FrankTrover/2023-Diansai-H/report/ppt图片/图片说明.txt

第一版加法器：第一版MCP602，电源导致带宽不足，电容过大充放电影响，截止频率没有调好
第一版后级放大电路：TL072由于频率升高后电路中寄生电容和运放有限带宽的影响增强，使负反馈性能下降并产生相位滞后，从而导致输出波形失真。
第二版加法器：两路跟随输出经加法电阻汇合属于正常工作方式，输出出现尖峰及 0 V 平台主要是由于高频下后级反相求和电路在面包板上的长连线和寄生参数影响负反馈稳定性，使虚地点产生波动，运放进入瞬态非线性状态，从而造成波形畸变。
