FrankTrover/2023-Diansai-H/report/ppt图片/第一版加法器 (2).jpg

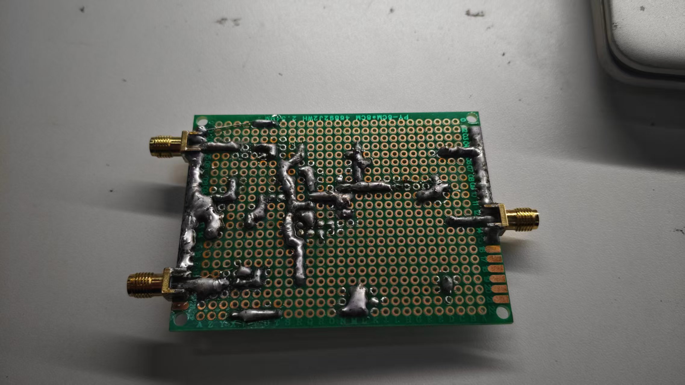
report/ppt图片/第一版加法器 (2).jpg
