FrankTrover/2023-Diansai-H/report/ppt图片/第一版放大器 (3).jpg

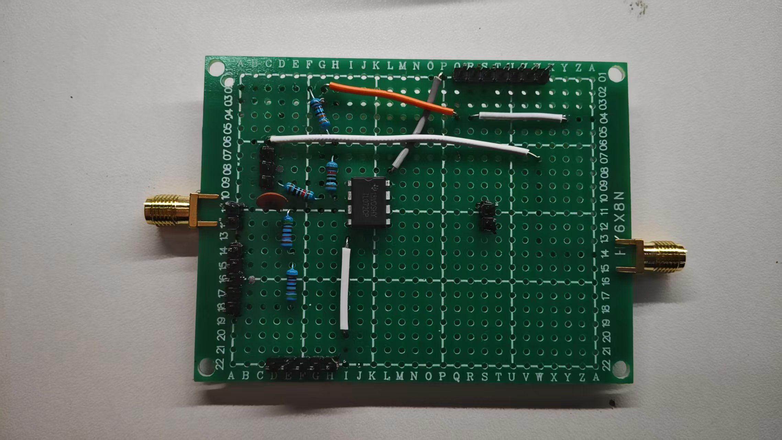
report/ppt图片/第一版放大器 (3).jpg
