FrankTrover/2023-Diansai-H/report/slide-01.jpg

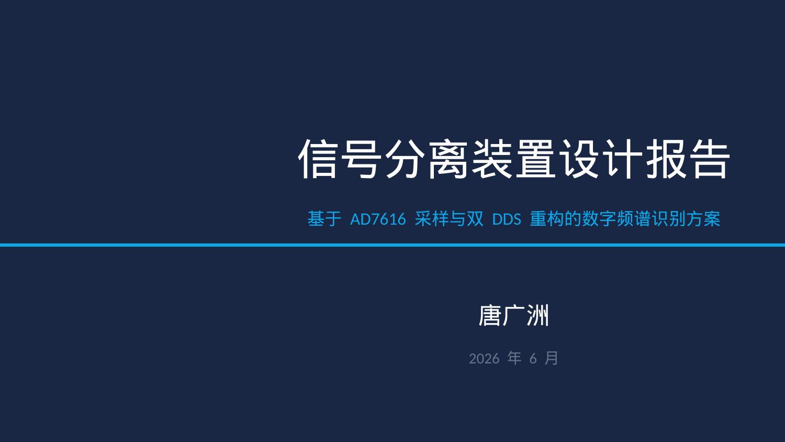
report/slide-01.jpg
