FrankTrover/2023-Diansai-H/report/slide-02.jpg

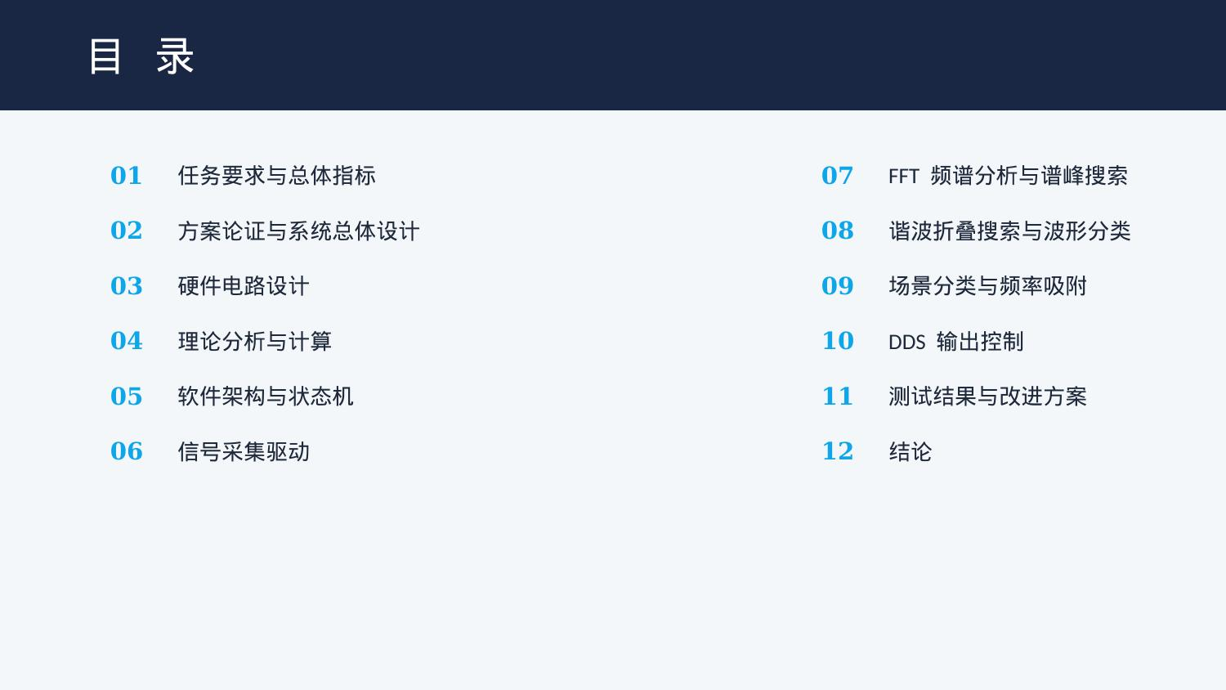
report/slide-02.jpg
