FrankTrover/2023-Diansai-H/report/slide-03.jpg

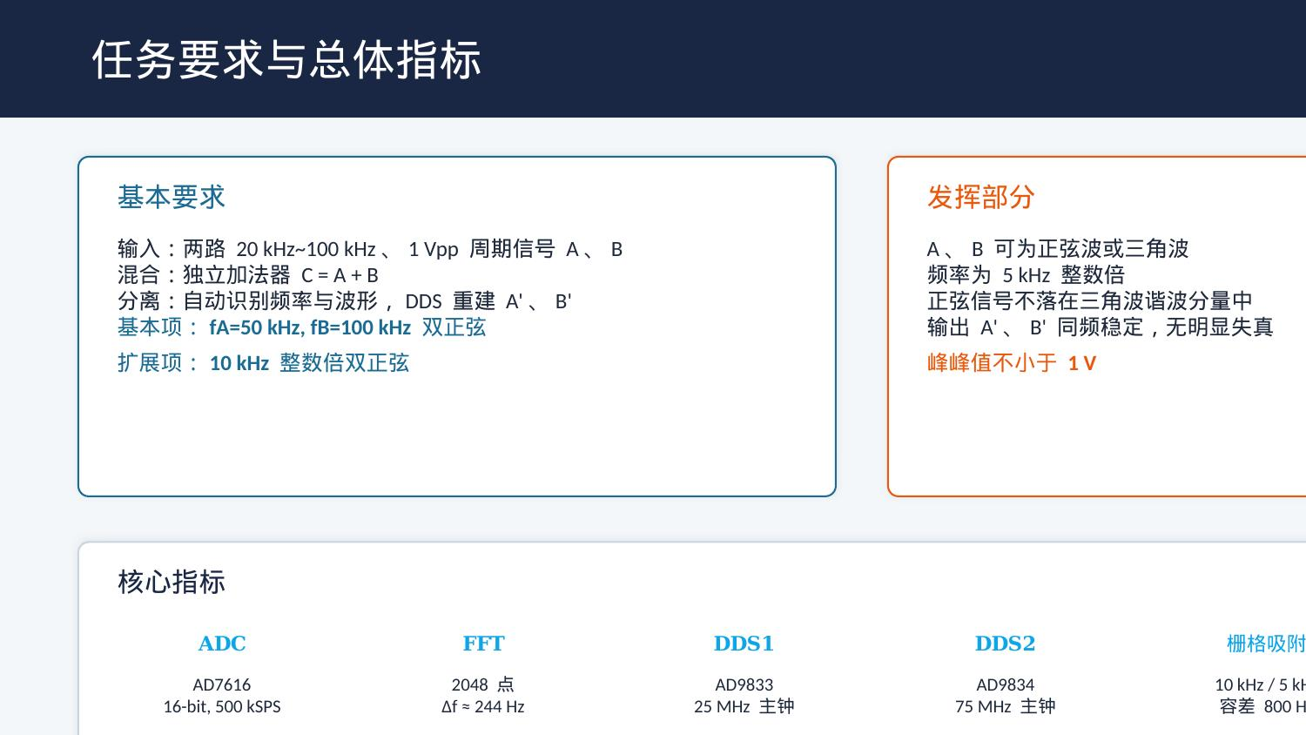
report/slide-03.jpg
