FrankTrover/2023-Diansai-H/report/slide-04.jpg

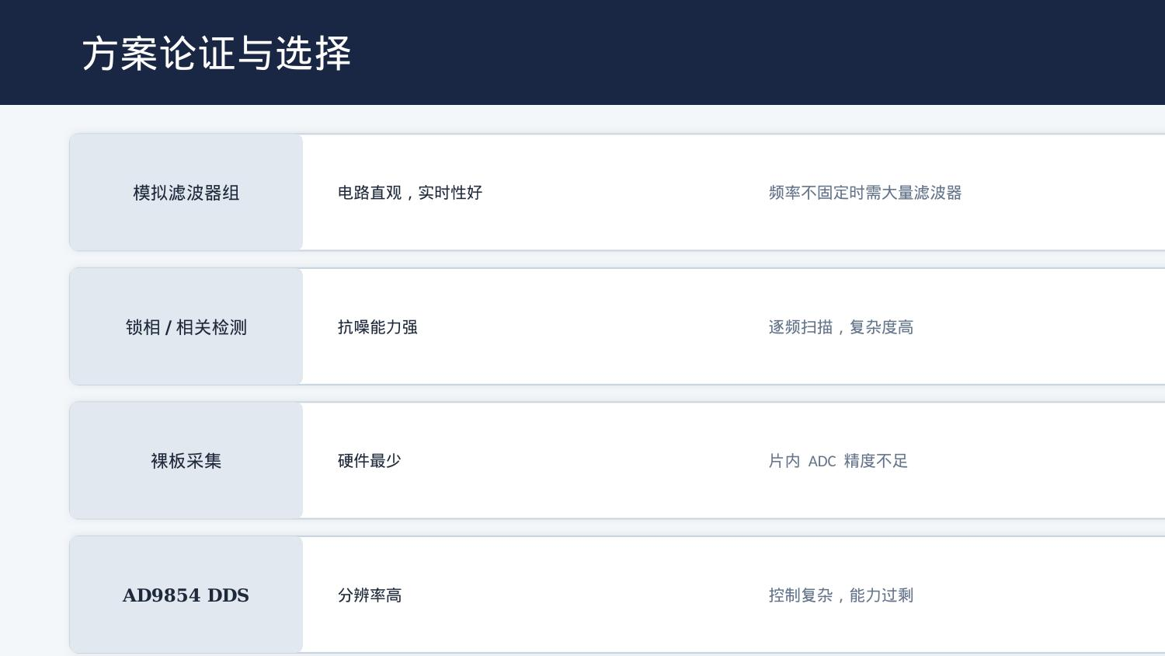
report/slide-04.jpg
