FrankTrover/2023-Diansai-H/report/slide-05.jpg

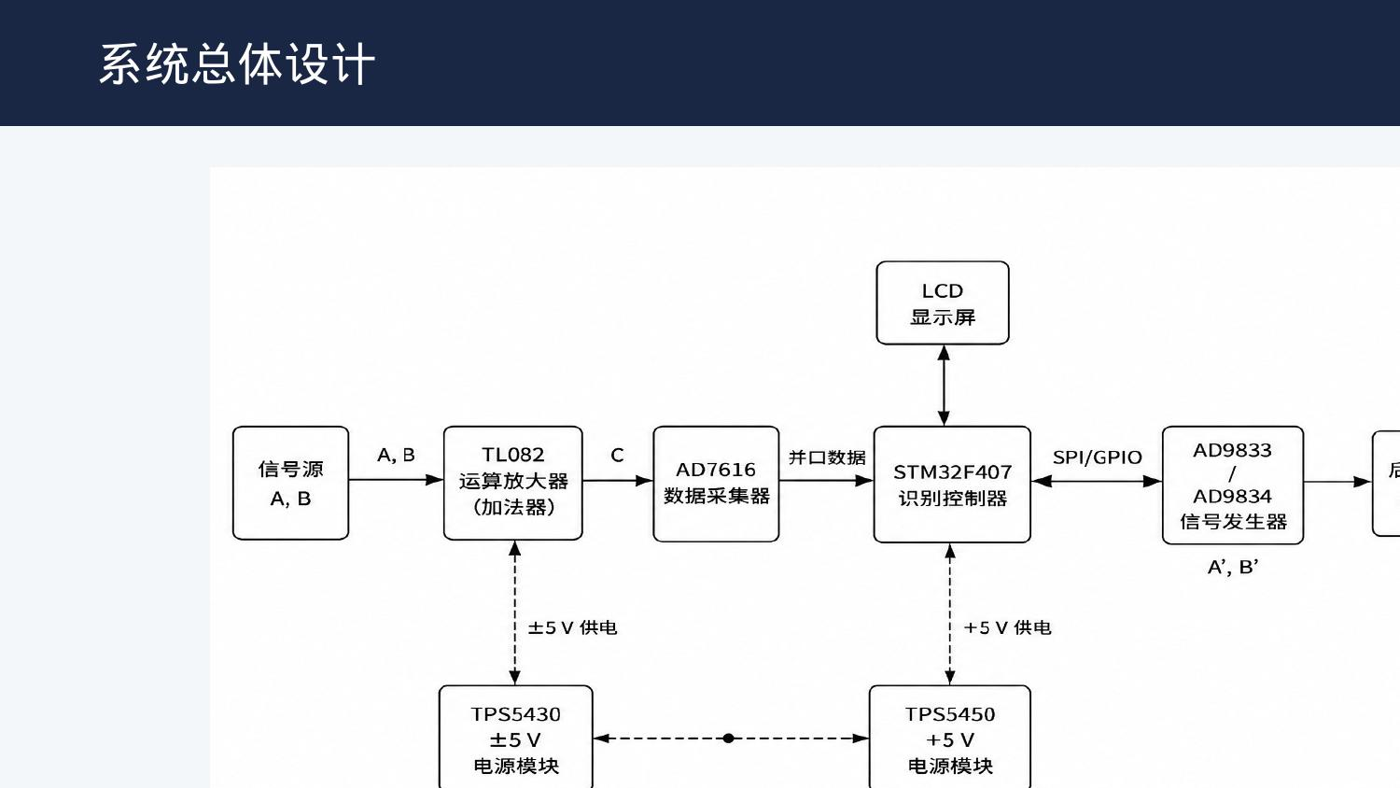
report/slide-05.jpg
