FrankTrover/2023-Diansai-H/report/slide-06.jpg

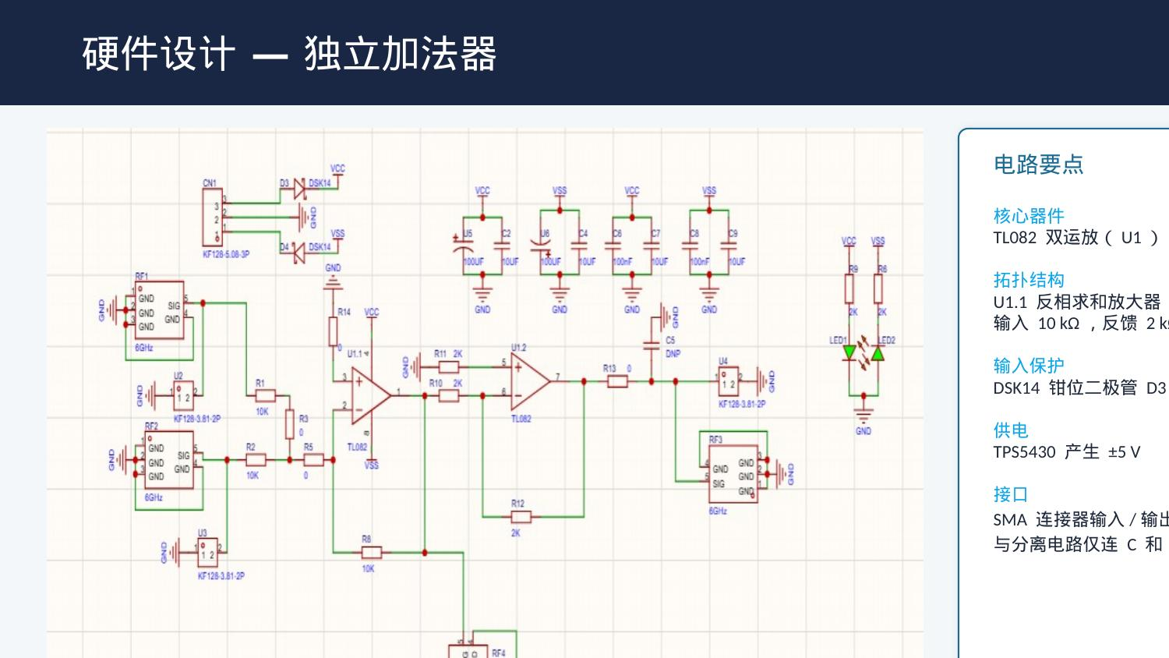
report/slide-06.jpg
