FrankTrover/2023-Diansai-H/report/slide-07.jpg

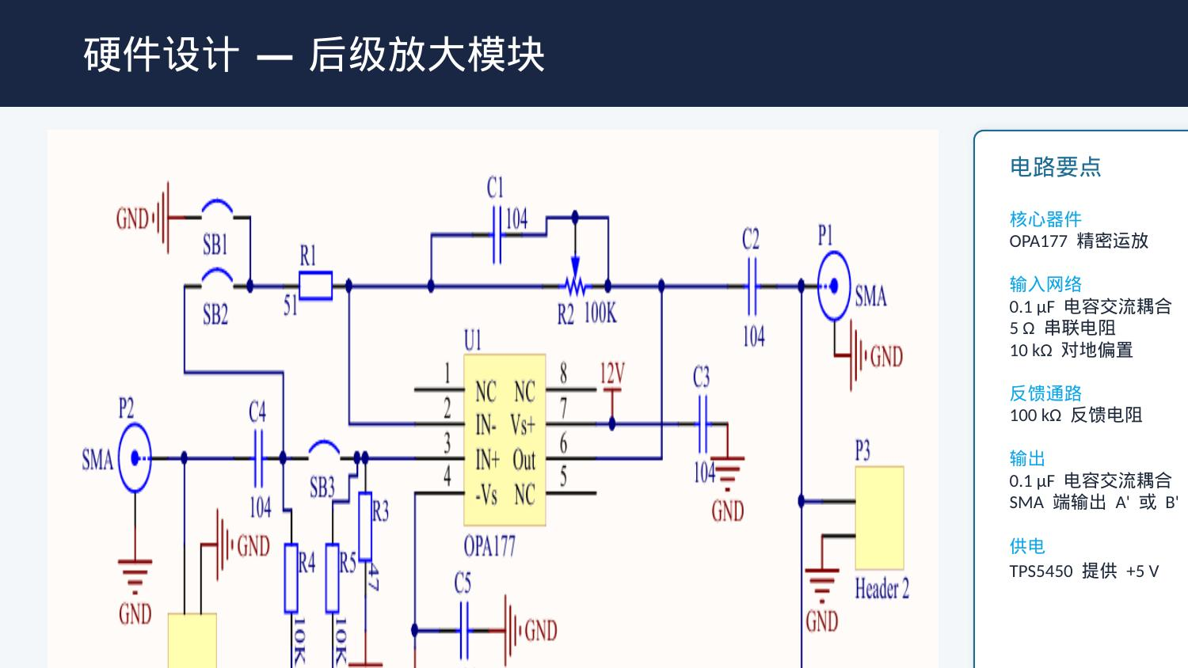
report/slide-07.jpg
