FrankTrover/2023-Diansai-H/report/slide-08.jpg

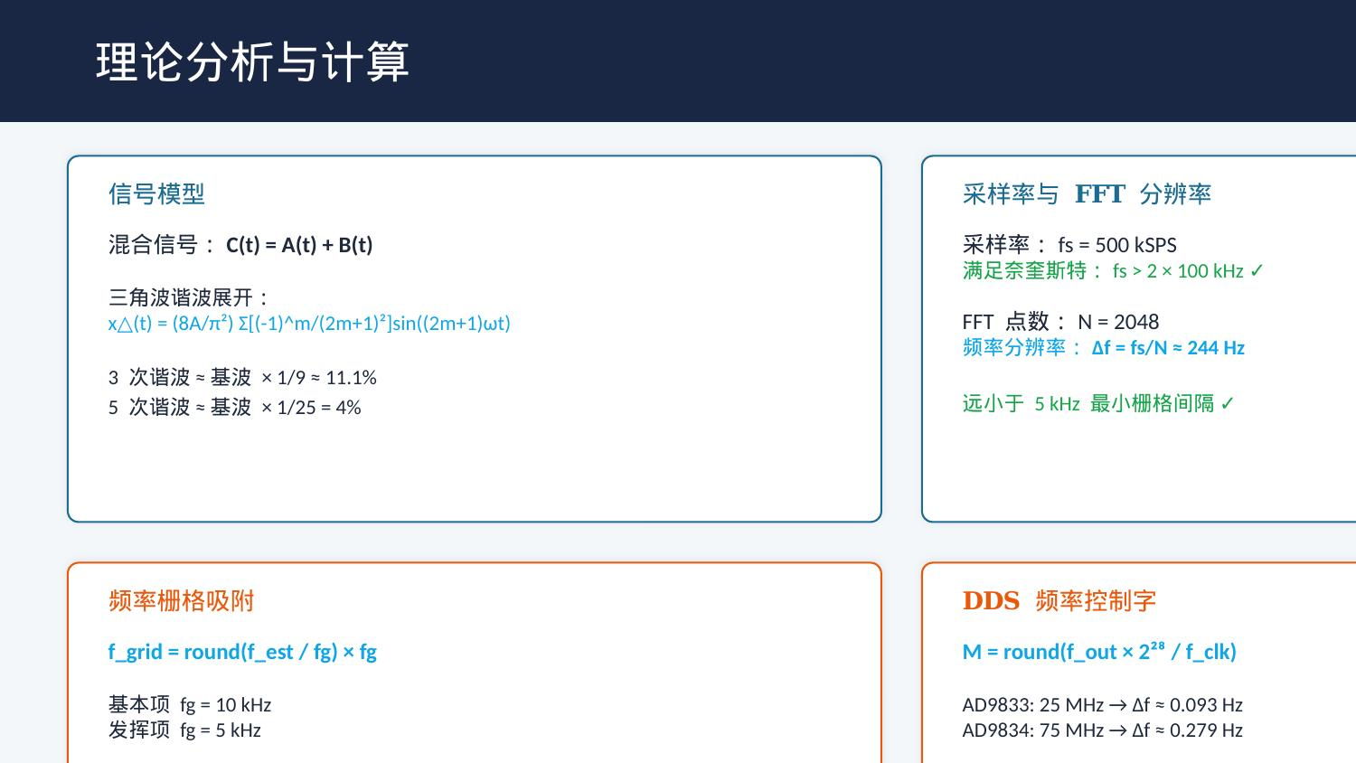
report/slide-08.jpg
