FrankTrover/2023-Diansai-H/report/slide-09.jpg

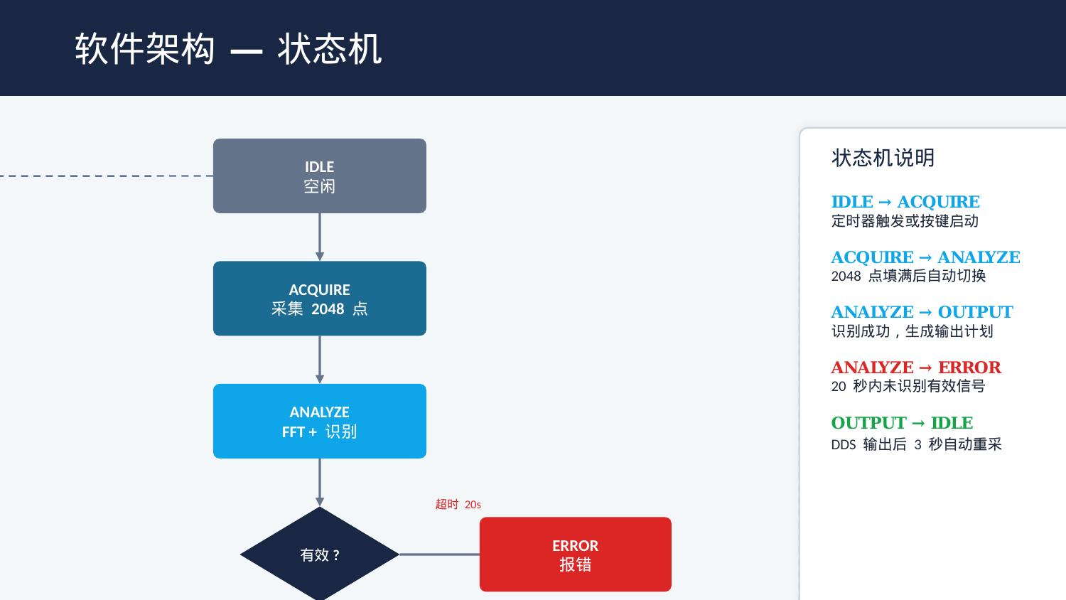
report/slide-09.jpg
