FrankTrover/2023-Diansai-H/report/slide-10.jpg

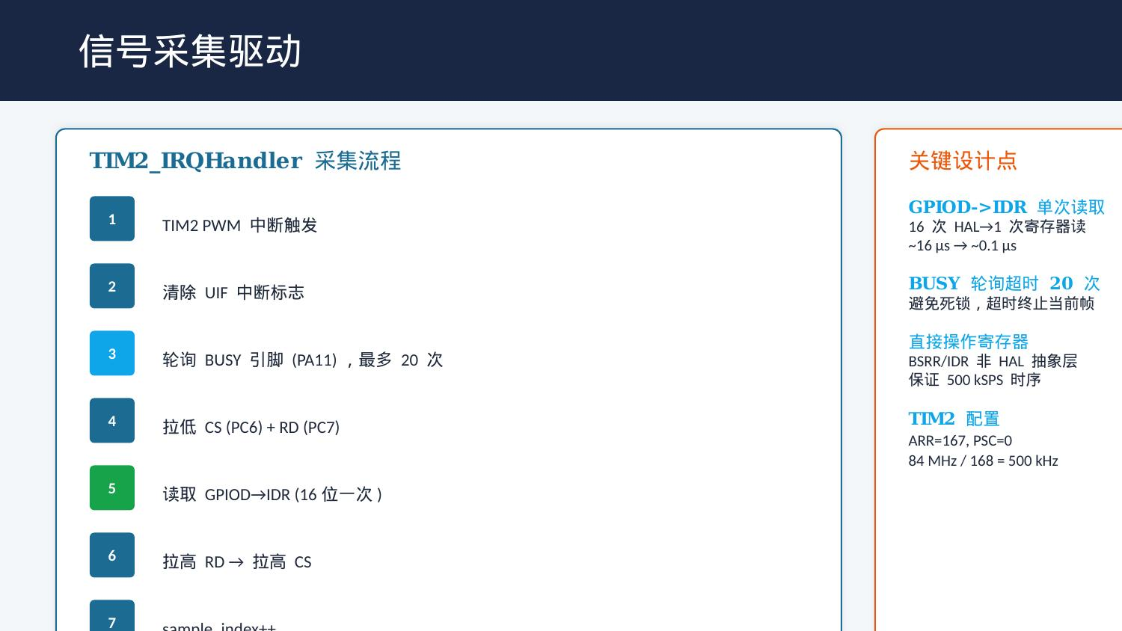
report/slide-10.jpg
