FrankTrover/2023-Diansai-H/report/slide-11.jpg

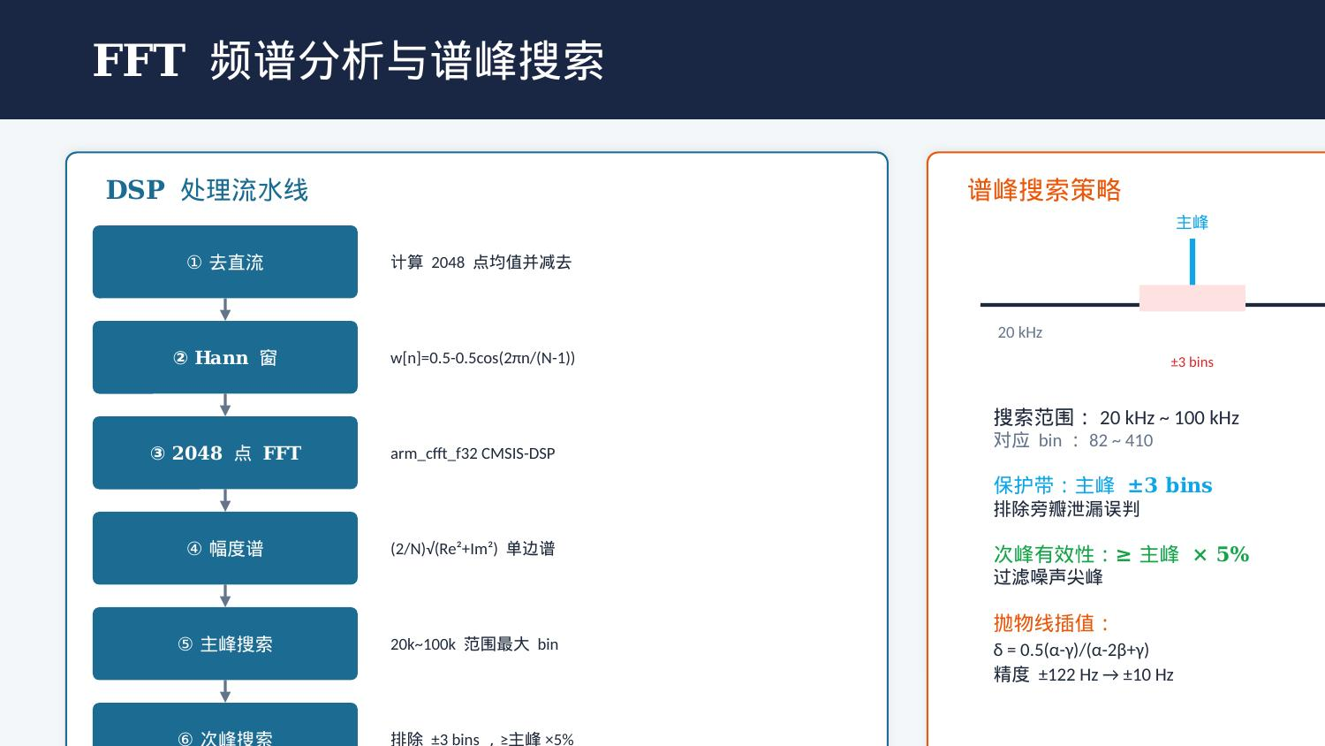
report/slide-11.jpg
