FrankTrover/2023-Diansai-H/report/slide-12.jpg

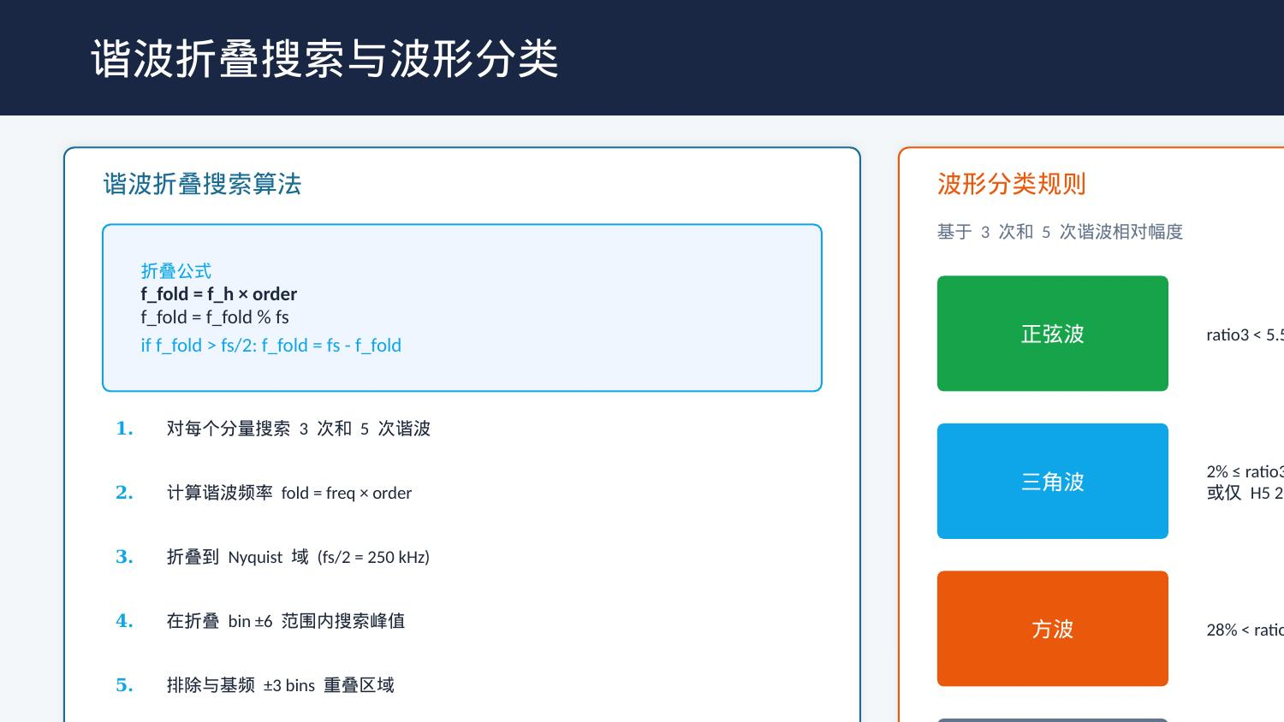
report/slide-12.jpg
