FrankTrover/2023-Diansai-H/report/slide-13.jpg

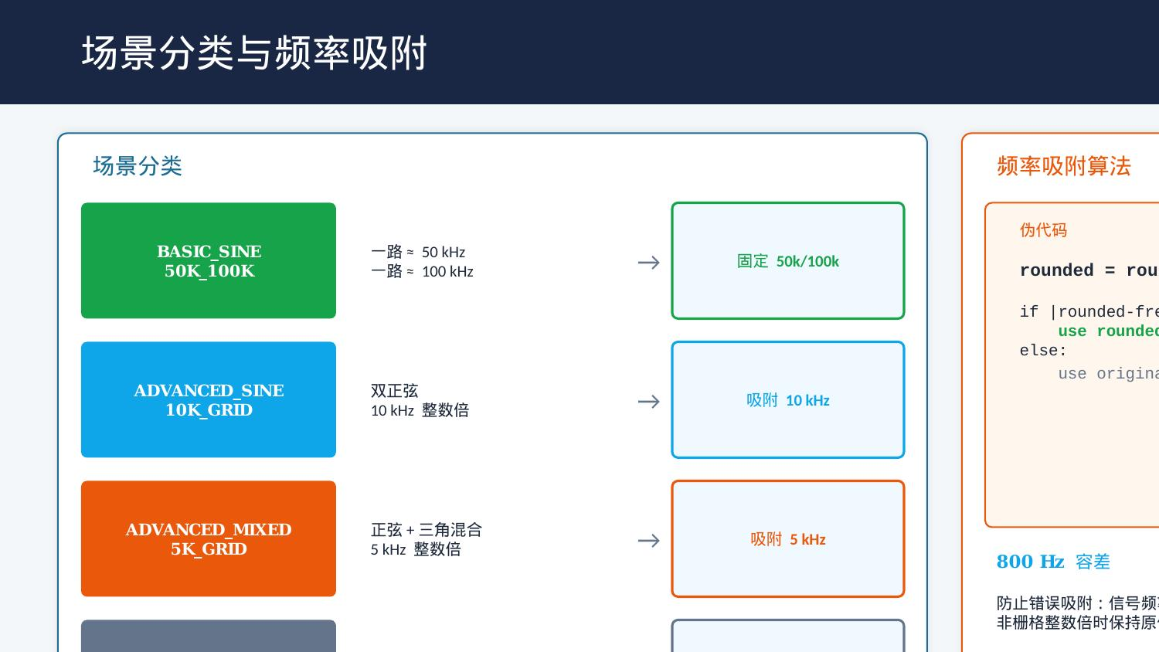
report/slide-13.jpg
