FrankTrover/2023-Diansai-H/report/slide-14.jpg

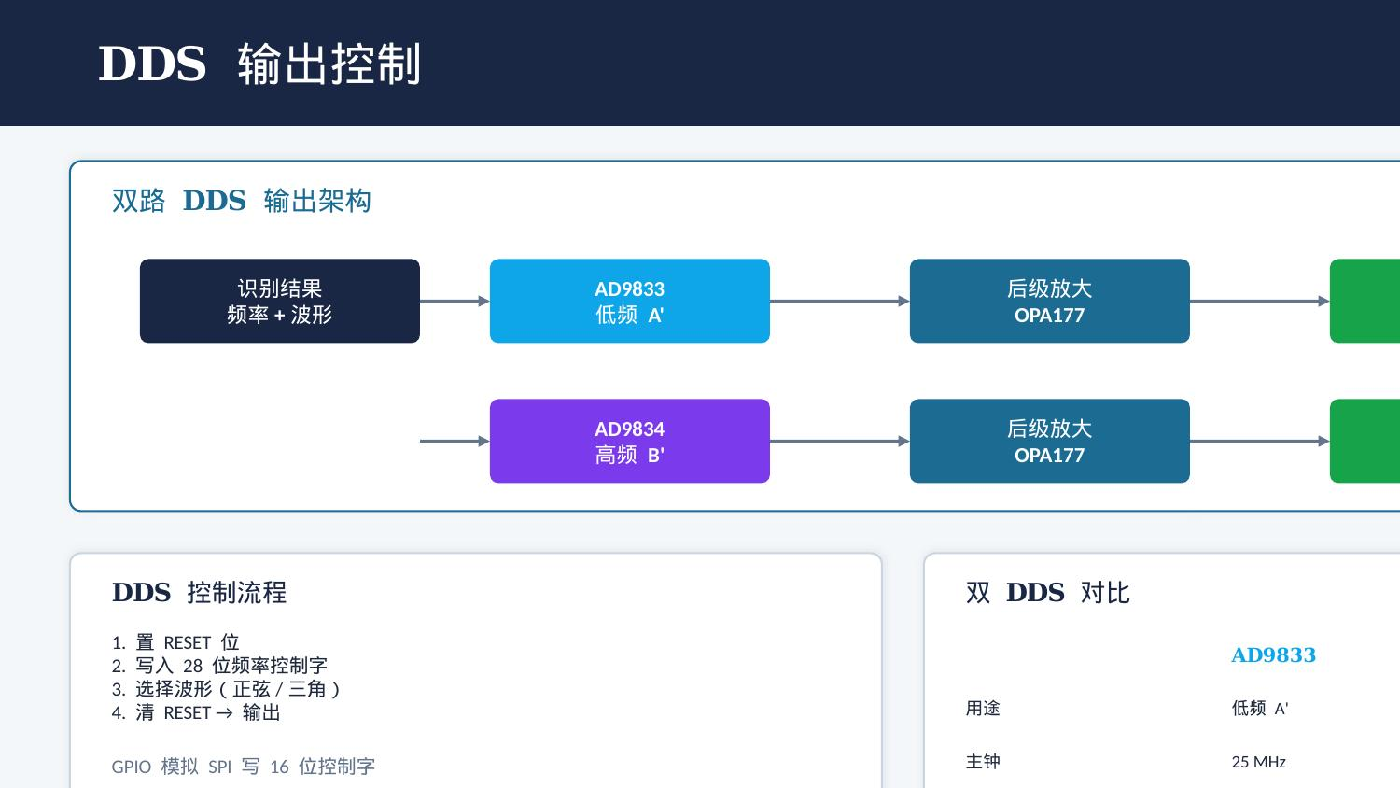
report/slide-14.jpg
