FrankTrover/2023-Diansai-H/report/slide-15.jpg

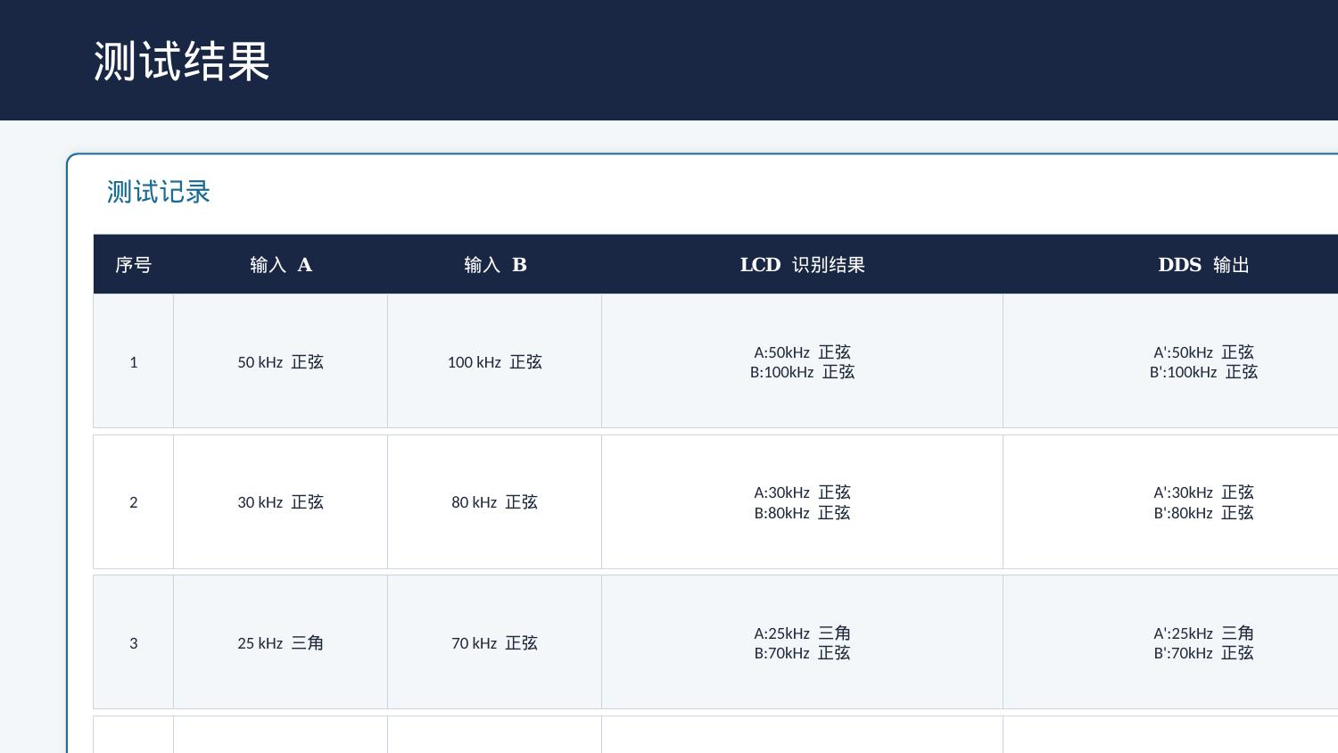
report/slide-15.jpg
