FrankTrover/2023-Diansai-H/report/slide-16.jpg

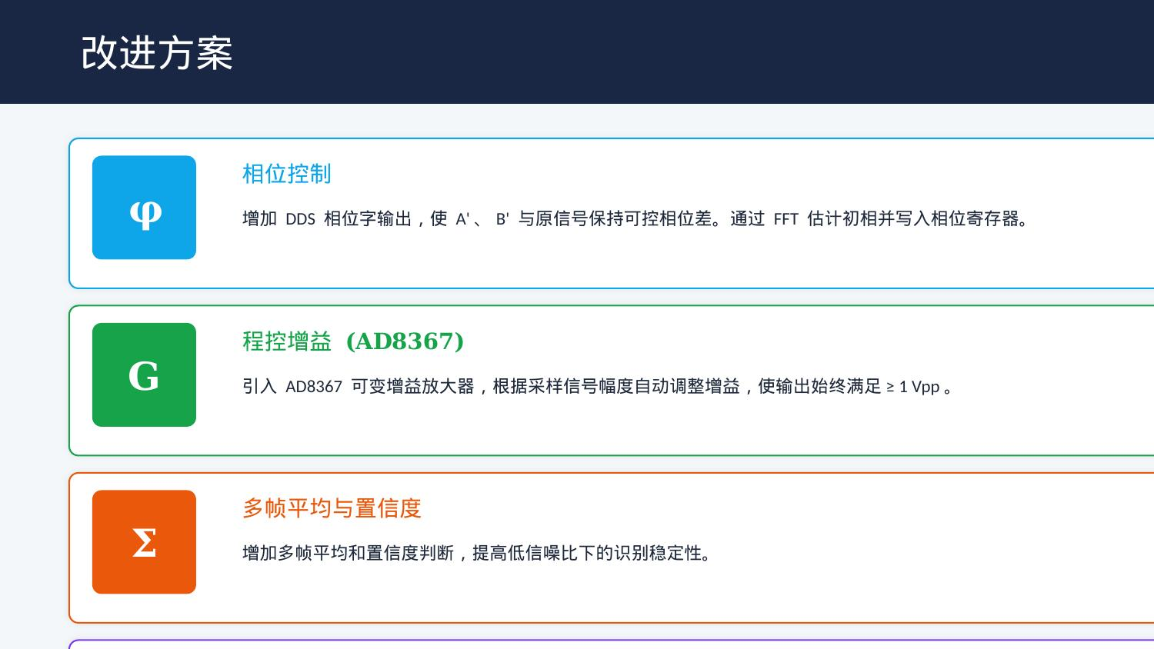
report/slide-16.jpg
