FrankTrover/2023-Diansai-H/report/slide-17.jpg

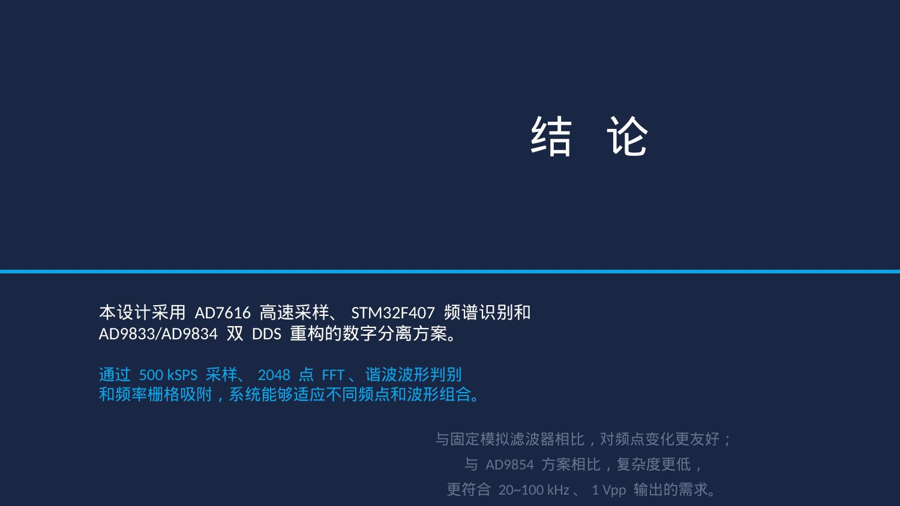
report/slide-17.jpg
