FrankTrover/2023-Diansai-H/Core/Inc/main.h

#define AD9834_FSY_Pin GPIO_PIN_2
#define AD9834_FSY_GPIO_Port GPIOE
#define AD9834_FS_Pin GPIO_PIN_3
#define AD9834_FS_GPIO_Port GPIOE
#define AD9834_SCK_Pin GPIO_PIN_4
#define AD9834_SCK_GPIO_Port GPIOE
#define AD9834_PS_Pin GPIO_PIN_5
#define AD9834_PS_GPIO_Port GPIOE
#define AD9834_SDA_Pin GPIO_PIN_6
#define AD9834_SDA_GPIO_Port GPIOE
#define AD9834_RST_Pin GPIO_PIN_0
#define AD9834_RST_GPIO_Port GPIOC
#define KEY_Pin GPIO_PIN_0
#define KEY_GPIO_Port GPIOA
#define AD9833_FSYNC_Pin GPIO_PIN_2
#define AD9833_FSYNC_GPIO_Port GPIOA
#define AD9833_SCLK_Pin GPIO_PIN_4
#define AD9833_SCLK_GPIO_Port GPIOA
#define AD9833_SDATA_Pin GPIO_PIN_6
#define AD9833_SDATA_GPIO_Port GPIOA
#define LEC_RED_Pin GPIO_PIN_5
#define LEC_RED_GPIO_Port GPIOC
#define LED_BULL_Pin GPIO_PIN_2
#define LED_BULL_GPIO_Port GPIOB
#define LCD_RES_Pin GPIO_PIN_10
#define LCD_RES_GPIO_Port GPIOB
#define LCD_BLK_Pin GPIO_PIN_11
#define LCD_BLK_GPIO_Port GPIOB
#define LCD_CS_Pin GPIO_PIN_12
#define LCD_CS_GPIO_Port GPIOB
#define LCD_SCL_Pin GPIO_PIN_13
#define LCD_SCL_GPIO_Port GPIOB
#define LCD_DC_Pin GPIO_PIN_14
#define LCD_DC_GPIO_Port GPIOB
#define LCD_SDA_Pin GPIO_PIN_15
#define LCD_SDA_GPIO_Port GPIOB
#define AD7616_D8_Pin GPIO_PIN_8
#define AD7616_D8_GPIO_Port GPIOD
#define AD7616_D9_Pin GPIO_PIN_9
#define AD7616_D9_GPIO_Port GPIOD
#define AD7616_D10_Pin GPIO_PIN_10
#define AD7616_D10_GPIO_Port GPIOD
#define AD7616_D11_Pin GPIO_PIN_11
#define AD7616_D11_GPIO_Port GPIOD
#define AD7616_D12_Pin GPIO_PIN_12
#define AD7616_D12_GPIO_Port GPIOD
#define AD7616_D13_Pin GPIO_PIN_13
#define AD7616_D13_GPIO_Port GPIOD
#define AD7616_D14_Pin GPIO_PIN_14
#define AD7616_D14_GPIO_Port GPIOD
#define AD7616_D15_Pin GPIO_PIN_15
#define AD7616_D15_GPIO_Port GPIOD
#define AD7616_CS_Pin GPIO_PIN_6
#define AD7616_CS_GPIO_Port GPIOC
#define AD7616_RD_Pin GPIO_PIN_7
#define AD7616_RD_GPIO_Port GPIOC
#define AD7616_WR_Pin GPIO_PIN_8
#define AD7616_WR_GPIO_Port GPIOC
#define AD7616_RST_Pin GPIO_PIN_9
#define AD7616_RST_GPIO_Port GPIOC
#define AD7616_CHS1_Pin GPIO_PIN_8
#define AD7616_CHS1_GPIO_Port GPIOA
#define AD7616_CHS2_Pin GPIO_PIN_9
#define AD7616_CHS2_GPIO_Port GPIOA
#define AD7616_S_P_Pin GPIO_PIN_10
#define AD7616_S_P_GPIO_Port GPIOA
#define AD7616_BUSY_Pin GPIO_PIN_11
#define AD7616_BUSY_GPIO_Port GPIOA
#define AD7616_CONV_Pin GPIO_PIN_15
#define AD7616_CONV_GPIO_Port GPIOA
#define AD7616_RNG0_Pin GPIO_PIN_10
#define AD7616_RNG0_GPIO_Port GPIOC
#define AD7616_RNG1_Pin GPIO_PIN_11
#define AD7616_RNG1_GPIO_Port GPIOC
#define AD7616_CHS0_Pin GPIO_PIN_12
#define AD7616_CHS0_GPIO_Port GPIOC
#define AD7616_D0_Pin GPIO_PIN_0
#define AD7616_D0_GPIO_Port GPIOD
#define AD7616_D1_Pin GPIO_PIN_1
#define AD7616_D1_GPIO_Port GPIOD
#define AD7616_D2_Pin GPIO_PIN_2
#define AD7616_D2_GPIO_Port GPIOD
#define AD7616_D3_Pin GPIO_PIN_3
#define AD7616_D3_GPIO_Port GPIOD
#define AD7616_D4_Pin GPIO_PIN_4
#define AD7616_D4_GPIO_Port GPIOD
#define AD7616_D5_Pin GPIO_PIN_5
#define AD7616_D5_GPIO_Port GPIOD
#define AD7616_D6_Pin GPIO_PIN_6
#define AD7616_D6_GPIO_Port GPIOD
#define AD7616_D7_Pin GPIO_PIN_7
#define AD7616_D7_GPIO_Port GPIOD
