FrankTrover/2023-Diansai-H/HARDWARE/INC/pic.h

#ifndef __PIC_H
#define __PIC_H

/*
 * LCD 示例图片数据 / LCD demo picture data.
 * 中文: 数组内容为原始 RGB565 像素字节流，主要用于显示接口联调。
 * English: The array stores raw RGB565 pixel data and is mainly used for LCD interface verification.
 * 中文: 使用时请保持图片尺寸、顺序和数组长度一致。
 * English: Keep the image size, byte order, and array length unchanged when using this data.
 */

const unsigned char gImage_1[3200] = { /* 0X10,0X10,0X00,0X28,0X00,0X28,0X01,0X1B, */
0XFF,0XFF,0XFF,0XFF,0XFF,0XFF,0XFF,0XFF,0XFF,0XFF,0XFF,0XFF,0XFF,0XFF,0XFF,0XFF,
0XFF,0XFF,0XFF,0XFF,0XFF,0XFF,0XFF,0XFF,0XFF,0XFF,0XFF,0XFF,0XFF,0XFF,0XF7,0XBE,
0XFF,0XFF,0XFF,0XDE,0XC6,0X38,0X8C,0X92,0X6B,0X8E,0X6B,0X6E,0X7C,0X10,0XAD,0X96,
0XE7,0X3C,0XFF,0XFF,0XFF,0XFF,0XFF,0XFF,0XFF,0XFF,0XFF,0XFF,0XFF,0XFF,0XFF,0XFF,
0XFF,0XFF,0XFF,0XFF,0XFF,0XFF,0XFF,0XFF,0XFF,0XFF,0XFF,0XFF,0XFF,0XFF,0XFF,0XFF,
0XFF,0XFF,0XFF,0XFF,0XFF,0XFF,0XFF,0XFF,0XFF,0XFF,0XFF,0XFF,0XFF,0XFF,0XFF,0XFF,
0XFF,0XFF,0XFF,0XFF,0XFF,0XFF,0XFF,0XFF,0XFF,0XFF,0XFF,0XFF,0XFF,0XFF,0XEF,0X5D,
0X9D,0X15,0X63,0X4F,0X42,0X6C,0X32,0X0A,0X29,0X88,0X19,0X46,0X19,0X25,0X21,0X45,
0X31,0XE8,0X6B,0X8E,0XC6,0X38,0XFF,0XFF,0XFF,0XFF,0XFF,0XFF,0XFF,0XFF,0XFF,0XFF,
0XFF,0XFF,0XFF,0XFF,0XFF,0XFF,0XFF,0XFF,0XFF,0XFF,0XFF,0XFF,0XFF,0XFF,0XFF,0XFF,
0XFF,0XFF,0XFF,0XFF,0XFF,0XFF,0XFF,0XFF,0XFF,0XFF,0XFF,0XFF,0XFF,0XFF,0XFF,0XFF,
0XFF,0XFF,0XFF,0XFF,0XFF,0XFF,0XFF,0XFF,0XFF,0XFF,0XFF,0XFF,0XA5,0X36,0X53,0X10,
0X4B,0X10,0X53,0X51,0X4B,0X0F,0X3A,0X6C,0X31,0XE9,0X21,0X67,0X19,0X25,0X10,0XE4,
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
0X86,0XDB,0X86,0XDB,0X86,0XDB,0X86,0XDB,0X86,0XDB,0X86,0XDB,0X86,0XDB,0X86,0XDB,
0X7E,0XDA,0X7E,0XFA,0X7E,0XFA,0X7F,0X1A,0X86,0XDB,0X86,0XDA,0X86,0XDB,0X86,0XDA,
0X86,0XBA,0X86,0X99,0X97,0X1C,0X8E,0XDA,0X8E,0XFB,0X8F,0X1B,0X86,0XDA,0X86,0XFA,
};



#endif
